johnyHV/USB_HUB_-_4x_FT232RL/Photo/P_20200420_203056.jpg

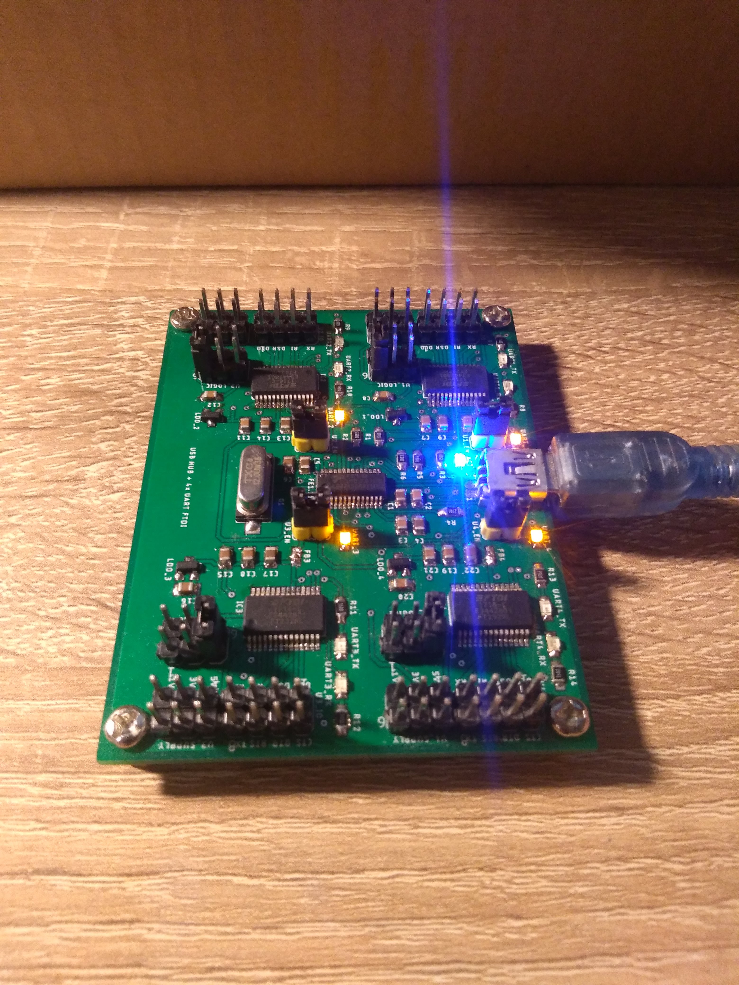
Photo/P_20200420_203056.jpg
