johnyHV/USB_HUB_-_4x_FT232RL/README.md

# USB_HUB_-_4x_FT232RL

- USB HUB with FE1.1 chip
- 4x FTDI FT-232RL chip
- 1,8V, 3,3V, 5V logic level

Image description

Image description

Image description
