johnyHV/USB_HUB_-_4x_FT232RL/Photo/USB hub & FTDI PCB TOP.png

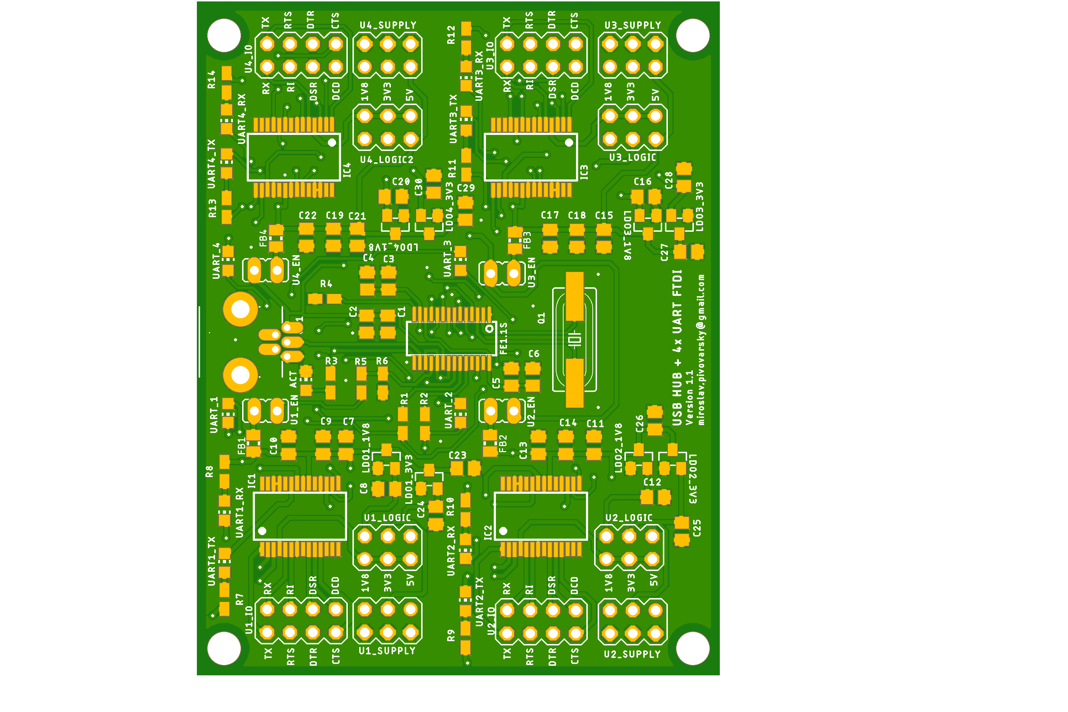
Photo/USB hub & FTDI PCB TOP.png
