johnyHV/USB_HUB_-_4x_FT232RL/USB hub & FTDI.brd

## EAGLE design USB hub & FTDI.brd (2020-05-18)

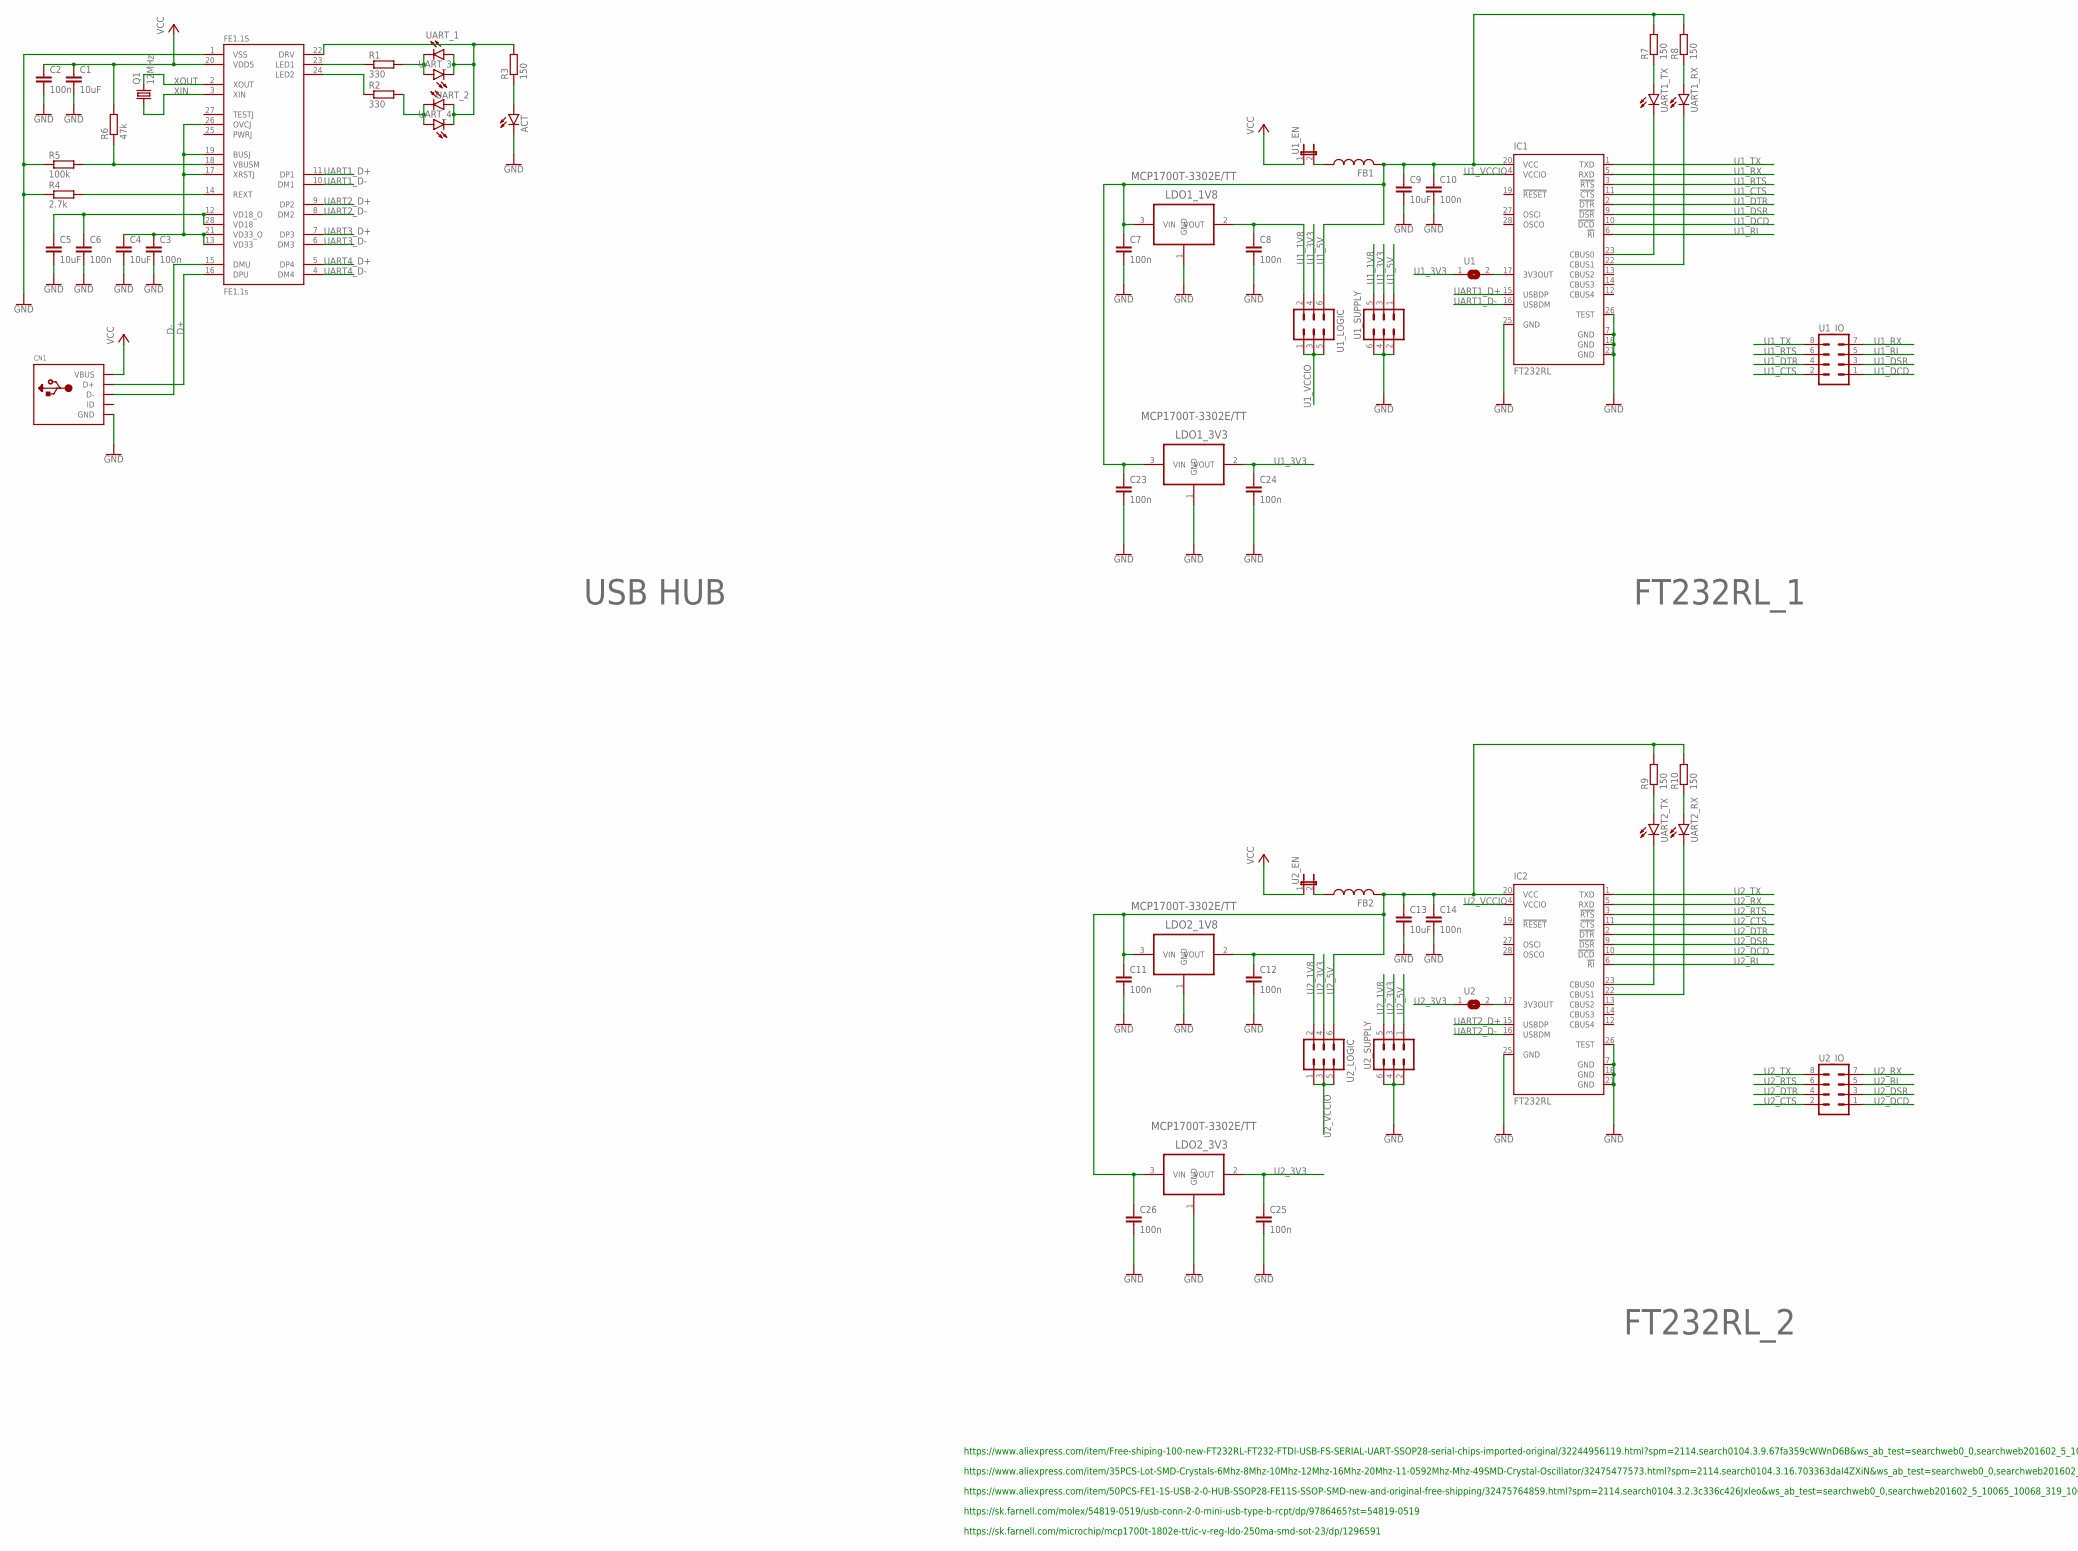
[picture p12: schematic USB hub & FTDI.sch, part in row 1, column 1]

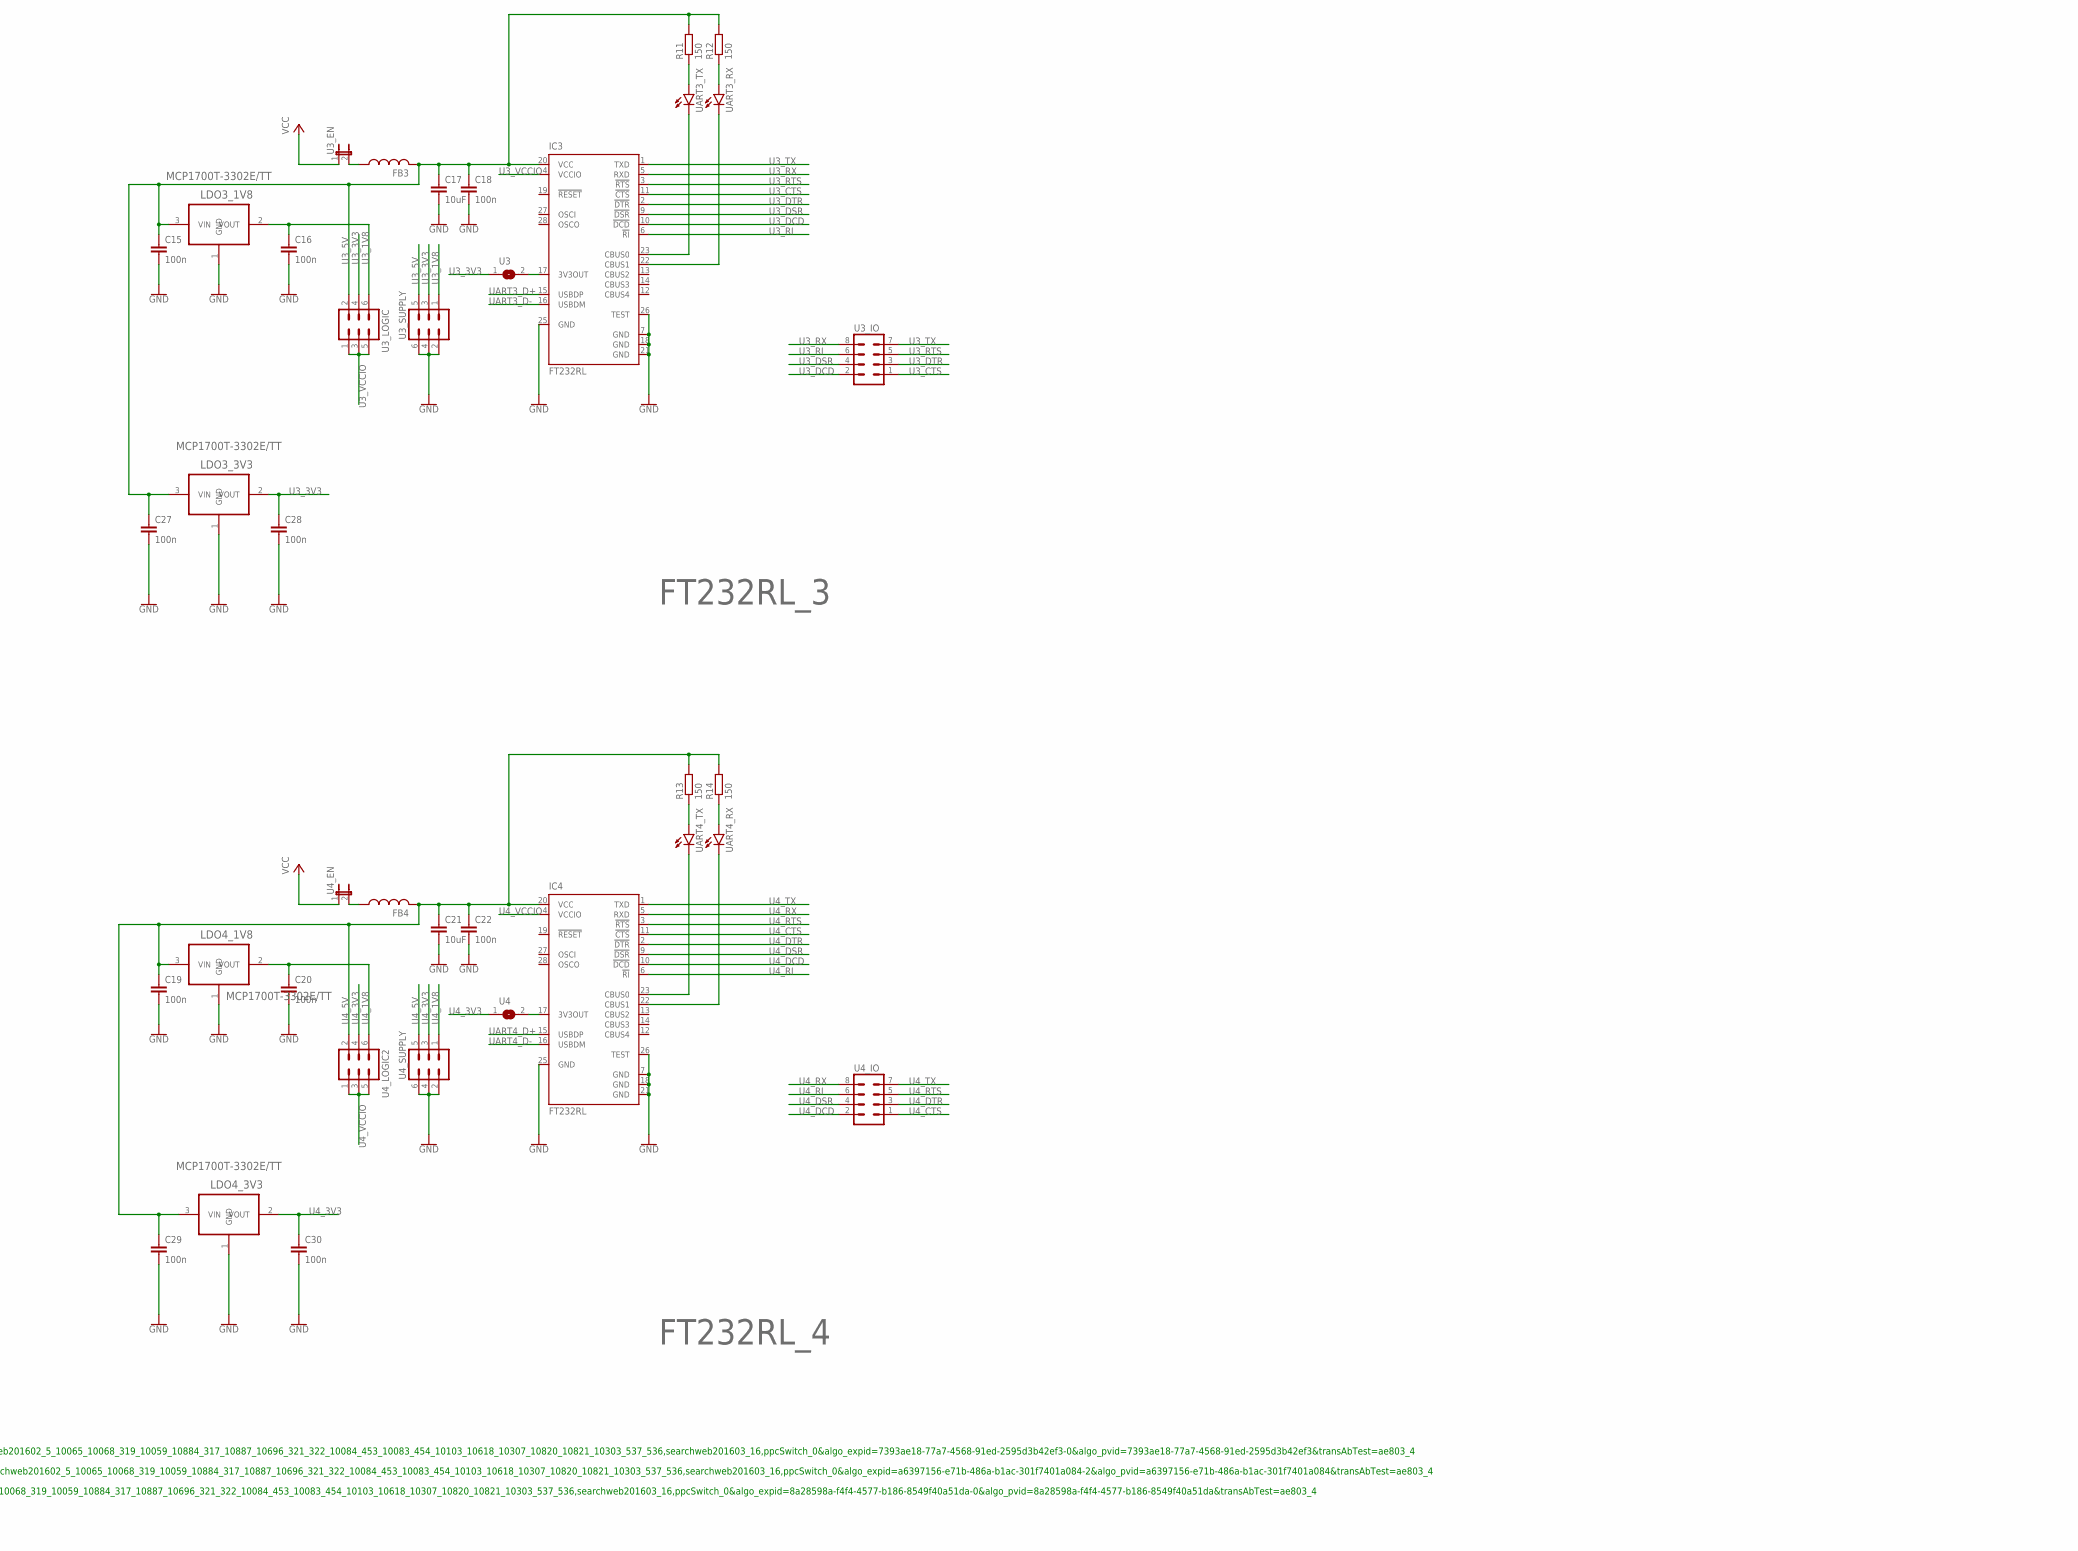
[picture p13: schematic USB hub & FTDI.sch, part in row 1, column 2]

Parts:
ACT: LEDCHIP-LED0805; CHIP-LED0805
C1, C4, C5, C9, C13, C17, C21: 10uF; C0805
C2, C3, C6, C7, C8, C10, C11, C12, C14, C15, C16, C18, C19, C20, C22, C23, C24, C25, C26, C27, C28, C29, C30: 100n; C0805
CN1: USBMOLEX; USB-MINIB-THM-MOLEX
FB1, FB2, FB3, FB4: FERRITE-BEADB; 0805
FE1.1S: FE1.1S; FE1.1S_SSOP-28
IC1, IC2, IC3, IC4: FT232RL; SSOP28
LDO1_1V8, LDO1_3V3, LDO2_1V8, LDO2_3V3, LDO3_1V8, LDO3_3V3, LDO4_1V8, LDO4_3V3: MCP1700T-3302E/TT; SOT95P237X112-3N
Q1: 12MHz; HC49UP
R1, R2: 330; R0805W
R3, R7, R8, R9, R10, R11, R12, R13, R14: 150; R0805W
R4: 2.7k; R0805W
R5: 100k; R0805W
R6: 47k; R0805W
U1, U2, U3, U4: SJ
U1_EN, U2_EN, U3_EN, U4_EN: JP1E; JP1
U1_IO, U2_IO, U3_IO, U4_IO: MA04-2
U1_LOGIC, U1_SUPPLY, U2_LOGIC, U2_SUPPLY, U3_LOGIC, U3_SUPPLY, U4_LOGIC2, U4_SUPPLY: MA03-2
UART1_RX, UART1_TX, UART2_RX, UART2_TX, UART3_RX, UART3_TX, UART4_RX, UART4_TX: LEDCHIP-LED0805; CHIP-LED0805
UART_1, UART_2, UART_3, UART_4: LEDCHIP-LED0805; CHIP-LED0805

Connections:
D+: CN1.D+, FE1.1S.16 (DPU)
D-: CN1.D-, FE1.1S.15 (DMU)
GND: ACT.C, C1.2, C2.2, C3.2, C4.2, C5.2, C6.2, C7.2, C8.2, C9.2, C10.2, C11.2, C12.2, C13.2, C14.2, C15.2, C16.2, C17.2, C18.2, C19.2, C20.2, C21.2, C22.2, C23.2, C24.2, C25.2, C26.2, C27.2, C28.2, C29.2, C30.2, CN1.GND, FE1.1S.1 (VSS), IC1.7 (GND), IC1.18 (GND), IC1.21 (GND), IC1.25 (GND), IC1.26 (TEST), IC2.7 (GND), IC2.18 (GND), IC2.21 (GND), IC2.25 (GND), IC2.26 (TEST), IC3.7 (GND), IC3.18 (GND), IC3.21 (GND), IC3.25 (GND), IC3.26 (TEST), IC4.7 (GND), IC4.18 (GND), IC4.21 (GND), IC4.25 (GND), IC4.26 (TEST), LDO1_1V8.1 (GND), LDO1_3V3.1 (GND), LDO2_1V8.1 (GND), LDO2_3V3.1 (GND), LDO3_1V8.1 (GND), LDO3_3V3.1 (GND), LDO4_1V8.1 (GND), LDO4_3V3.1 (GND), R4.1, R5.1, U1_SUPPLY.2, U1_SUPPLY.4, U1_SUPPLY.6, U2_SUPPLY.2, U2_SUPPLY.4, U2_SUPPLY.6, U3_SUPPLY.2, U3_SUPPLY.4, U3_SUPPLY.6, U4_SUPPLY.2, U4_SUPPLY.4, U4_SUPPLY.6
unnamed: FE1.1S.23 (LED1), R1.1
unnamed: FE1.1S.24 (LED2), R2.1
unnamed: R1.2, UART_1.C, UART_3.A
unnamed: R2.2, UART_2.C, UART_4.A
unnamed: C5.1, C6.1, FE1.1S.12 (VD18_O), FE1.1S.28 (VD18)
unnamed: R9.1, UART2_TX.A
unnamed: FE1.1S.22 (DRV), R3.2, UART_1.A, UART_2.A, UART_3.C, UART_4.C
unnamed: R7.1, UART1_TX.A
unnamed: ACT.A, R3.1
unnamed: FE1.1S.18 (VBUSM), R5.2, R6.1
unnamed: FE1.1S.14 (REXT), R4.2
unnamed: C3.1, C4.1, FE1.1S.13 (VD33), FE1.1S.17 (XRSTJ), FE1.1S.19 (BUSJ), FE1.1S.21 (VD33_O), FE1.1S.26 (OVCJ)
unnamed: R8.1, UART1_RX.A
unnamed: IC1.23 (CBUS0), UART1_TX.C
unnamed: IC1.22 (CBUS1), UART1_RX.C
unnamed: R10.1, UART2_RX.A
unnamed: IC2.23 (CBUS0), UART2_TX.C
unnamed: IC2.22 (CBUS1), UART2_RX.C
unnamed: FB2.1, U2_EN.2
unnamed: R11.1, UART3_TX.A
unnamed: R12.1, UART3_RX.A
unnamed: IC3.23 (CBUS0), UART3_TX.C
unnamed: IC3.22 (CBUS1), UART3_RX.C
unnamed: FB3.1, U3_EN.2
unnamed: FB1.1, U1_EN.2
unnamed: R13.1, UART4_TX.A
unnamed: R14.1, UART4_RX.A
unnamed: IC4.23 (CBUS0), UART4_TX.C
unnamed: IC4.22 (CBUS1), UART4_RX.C
unnamed: FB4.1, U4_EN.2
unnamed: IC1.17 (3V3OUT), U1.2
unnamed: IC2.17 (3V3OUT), U2.2
unnamed: IC3.17 (3V3OUT), U3.2
unnamed: IC4.17 (3V3OUT), U4.2
U1_1V8: C8.1, LDO1_1V8.2 (VOUT), U1_LOGIC.2, U1_SUPPLY.5
U1_3V3: C24.1, LDO1_3V3.2 (VOUT), U1.1, U1_LOGIC.4, U1_SUPPLY.3
U1_5V: C7.1, C9.1, C10.1, C23.1, FB1.2, IC1.20 (VCC), LDO1_1V8.3 (VIN), LDO1_3V3.3 (VIN), R7.2, R8.2, U1_LOGIC.6, U1_SUPPLY.1
U1_CTS: IC1.11 (!CTS), U1_IO.2
U1_DCD: IC1.10 (!DCD), U1_IO.1
U1_DSR: IC1.9 (!DSR), U1_IO.3
U1_DTR: IC1.2 (!DTR), U1_IO.4
U1_RI: IC1.6 (!RI), U1_IO.5
U1_RTS: IC1.3 (!RTS), U1_IO.6
U1_RX: IC1.5 (RXD), U1_IO.7
U1_TX: IC1.1 (TXD), U1_IO.8
U1_VCCIO: IC1.4 (VCCIO), U1_LOGIC.1, U1_LOGIC.3, U1_LOGIC.5
U2_1V8: C12.1, LDO2_1V8.2 (VOUT), U2_LOGIC.2, U2_SUPPLY.5
U2_3V3: C25.1, LDO2_3V3.2 (VOUT), U2.1, U2_LOGIC.4, U2_SUPPLY.3
U2_5V: C11.1, C13.1, C14.1, C26.1, FB2.2, IC2.20 (VCC), LDO2_1V8.3 (VIN), LDO2_3V3.3 (VIN), R9.2, R10.2, U2_LOGIC.6, U2_SUPPLY.1
U2_CTS: IC2.11 (!CTS), U2_IO.2
U2_DCD: IC2.10 (!DCD), U2_IO.1
U2_DSR: IC2.9 (!DSR), U2_IO.3
U2_DTR: IC2.2 (!DTR), U2_IO.4
U2_RI: IC2.6 (!RI), U2_IO.5
U2_RTS: IC2.3 (!RTS), U2_IO.6
U2_RX: IC2.5 (RXD), U2_IO.7
U2_TX: IC2.1 (TXD), U2_IO.8
U2_VCCIO: IC2.4 (VCCIO), U2_LOGIC.1, U2_LOGIC.3, U2_LOGIC.5
U3_1V8: C16.1, LDO3_1V8.2 (VOUT), U3_LOGIC.6, U3_SUPPLY.1
U3_3V3: C28.1, LDO3_3V3.2 (VOUT), U3.1, U3_LOGIC.4, U3_SUPPLY.3
U3_5V: C15.1, C17.1, C18.1, C27.1, FB3.2, IC3.20 (VCC), LDO3_1V8.3 (VIN), LDO3_3V3.3 (VIN), R11.2, R12.2, U3_LOGIC.2, U3_SUPPLY.5
U3_CTS: IC3.11 (!CTS), U3_IO.1
U3_DCD: IC3.10 (!DCD), U3_IO.2
U3_DSR: IC3.9 (!DSR), U3_IO.4
U3_DTR: IC3.2 (!DTR), U3_IO.3
U3_RI: IC3.6 (!RI), U3_IO.6
U3_RTS: IC3.3 (!RTS), U3_IO.5
U3_RX: IC3.5 (RXD), U3_IO.8
U3_TX: IC3.1 (TXD), U3_IO.7
U3_VCCIO: IC3.4 (VCCIO), U3_LOGIC.1, U3_LOGIC.3, U3_LOGIC.5
U4_1V8: C20.1, LDO4_1V8.2 (VOUT), U4_LOGIC2.6, U4_SUPPLY.1
U4_3V3: C30.1, LDO4_3V3.2 (VOUT), U4.1, U4_LOGIC2.4, U4_SUPPLY.3
U4_5V: C19.1, C21.1, C22.1, C29.1, FB4.2, IC4.20 (VCC), LDO4_1V8.3 (VIN), LDO4_3V3.3 (VIN), R13.2, R14.2, U4_LOGIC2.2, U4_SUPPLY.5
U4_CTS: IC4.11 (!CTS), U4_IO.1
U4_DCD: IC4.10 (!DCD), U4_IO.2
U4_DSR: IC4.9 (!DSR), U4_IO.4
U4_DTR: IC4.2 (!DTR), U4_IO.3
U4_RI: IC4.6 (!RI), U4_IO.6
U4_RTS: IC4.3 (!RTS), U4_IO.5
U4_RX: IC4.5 (RXD), U4_IO.8
U4_TX: IC4.1 (TXD), U4_IO.7
U4_VCCIO: IC4.4 (VCCIO), U4_LOGIC2.1, U4_LOGIC2.3, U4_LOGIC2.5
UART1_D+: FE1.1S.11 (DP1), IC1.15 (USBDP)
UART1_D-: FE1.1S.10 (DM1), IC1.16 (USBDM)
UART2_D+: FE1.1S.9 (DP2), IC2.15 (USBDP)
UART2_D-: FE1.1S.8 (DM2), IC2.16 (USBDM)
UART3_D+: FE1.1S.7 (DP3), IC3.15 (USBDP)
UART3_D-: FE1.1S.6 (DM3), IC3.16 (USBDM)
UART4_D+: FE1.1S.5 (DP4), IC4.15 (USBDP)
UART4_D-: FE1.1S.4 (DM4), IC4.16 (USBDM)
VCC: C1.1, C2.1, CN1.VBUS, FE1.1S.20 (VDD5), R6.2, U1_EN.1, U2_EN.1, U3_EN.1, U4_EN.1
XIN: FE1.1S.3 (XIN), Q1.1
XOUT: FE1.1S.2 (XOUT), Q1.2

Notes on the sheet:
https://www.aliexpress.com/item/Free-shiping-100-new-FT232RL-FT232-FTDI-USB-FS-SERIAL-UART-SSOP28-serial-chips-imported-original/32244956119.html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,searchweb201602_5_10065_10068_319_10059_10884_317_10887_10696_321_322_10084_453_10083_454_…
https://www.aliexpress.com/item/35PCS-Lot-SMD-Crystals-6Mhz-8Mhz-10Mhz-12Mhz-16Mhz-20Mhz-11-0592Mhz-Mhz-49SMD-Crystal-Oscillator/32475477573.html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,searchweb201602_5_10065_10068_319_10059_10884_317_10887_10696_321_322_10084_453_10083_454…
https://www.aliexpress.com/item/50PCS-FE1-1S-USB-2-0-HUB-SSOP28-FE11S-SSOP-SMD-new-and-original-free-shipping/32475764859.html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,searchweb201602_5_10065_10068_319_10059_10884_317_10887_10696_321_322_10084_453_10083_454_10103_10618_10307_1…
https://sk.farnell.com/molex/54819-0519/usb-conn-2-0-mini-usb-type-b-rcpt/dp/9786465?st=54819-0519
https://sk.farnell.com/microchip/mcp1700t-1802e-tt/ic-v-reg-ldo-250ma-smd-sot-23/dp/1296591
USB HUB
FT232RL_1
FT232RL_2
FT232RL_3
FT232RL_4

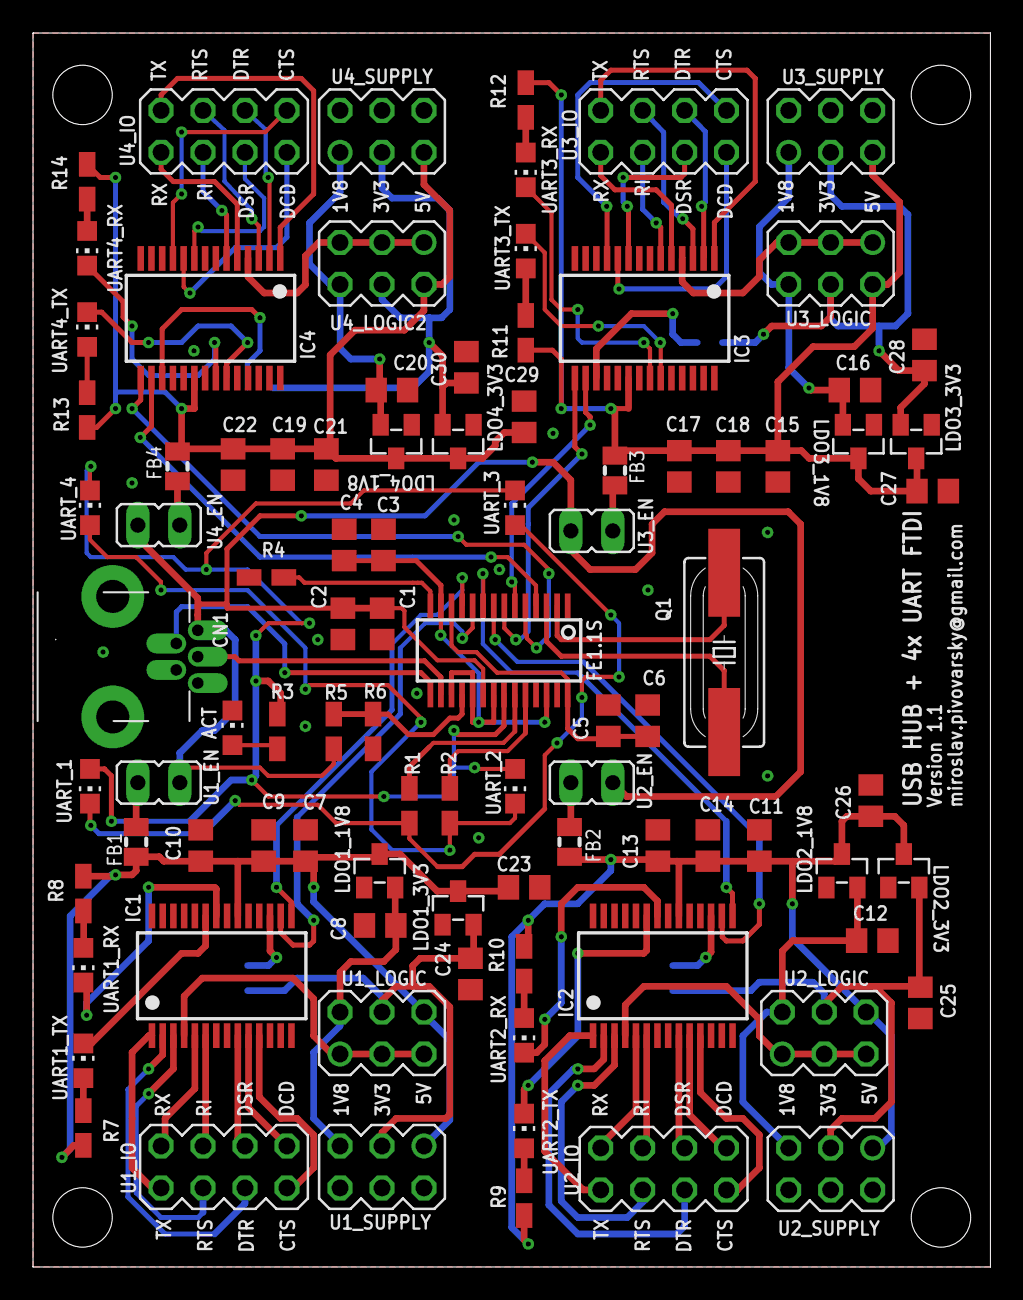
[picture p14: board USB hub & FTDI.brd from above]

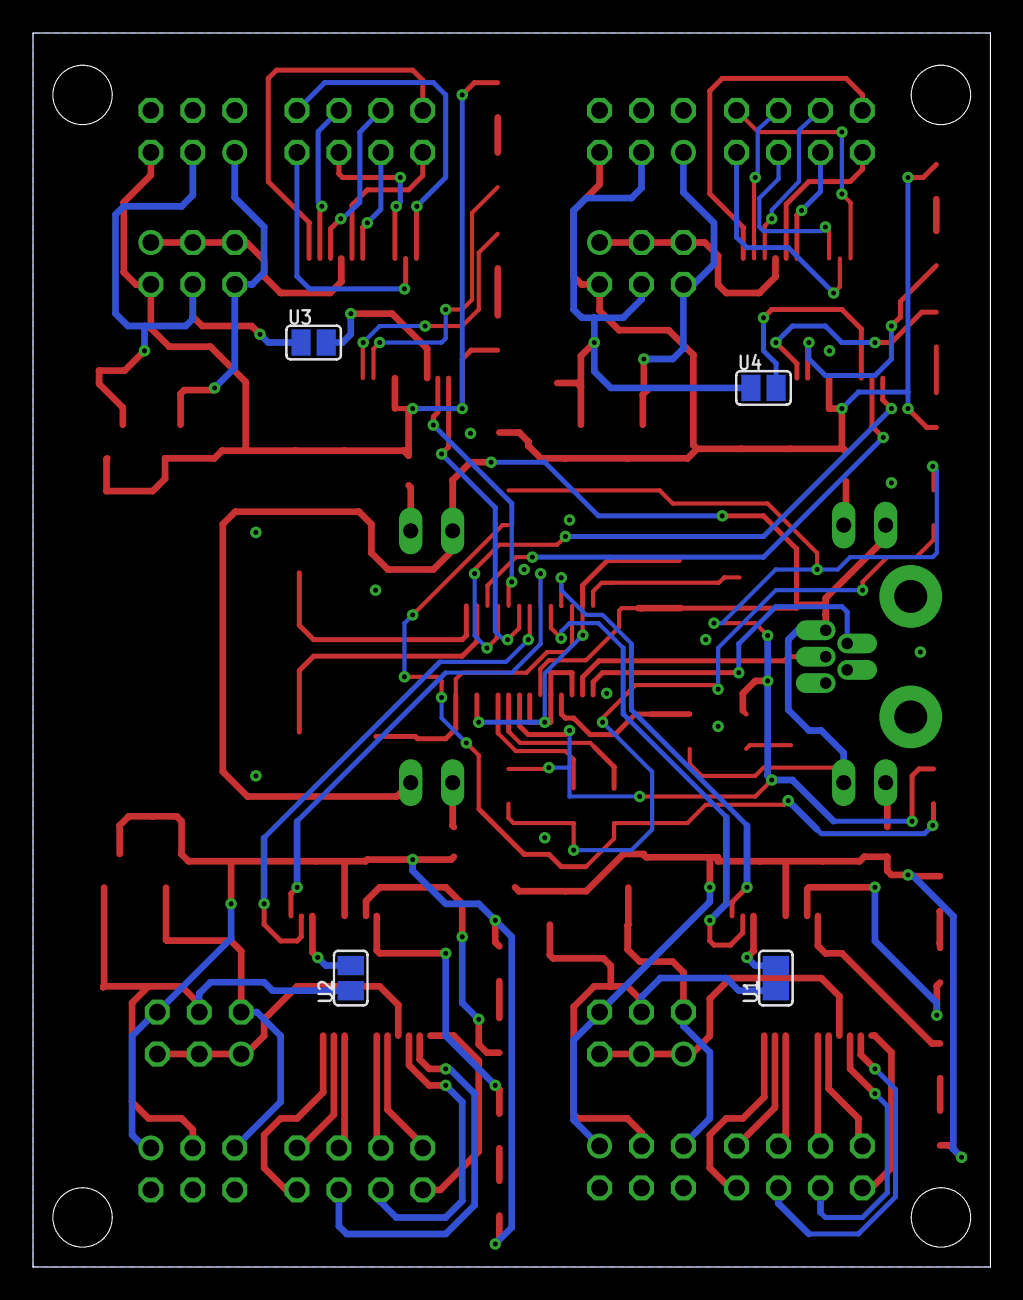
[picture p15: board USB hub & FTDI.brd from below]

Board: 2 copper layers, 58.0 x 74.8 mm, 96 parts (4 on the bottom side), 96 nets.
