johnyHV/USB_HUB_-_4x_FT232RL/(notices)

Notices in the files:
parts and their libraries:
SparkFun-PowerSymbols: Licensing: Creative Commons ShareAlike 4.0 International - https://creativecommons.org/licenses/by-sa/4.0
m-pad-2.1: License : GNU General Public License version 2 (see bottom)
